SeerLikeJazz/USB3300_SpeedTest/README.md

# USB3300_SpeedTest
stm32407+Usb3300, HS USB2.0 speed test  

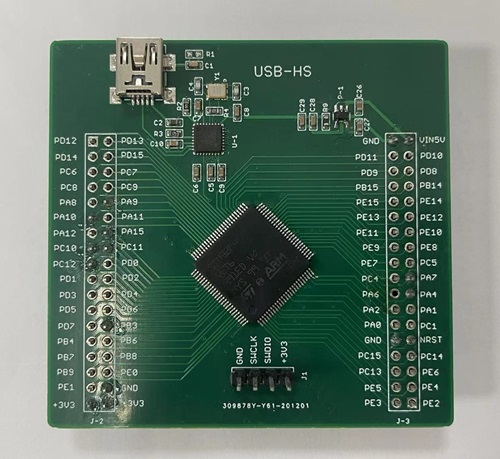
[picture p1: Image/PCB.jpg]
  
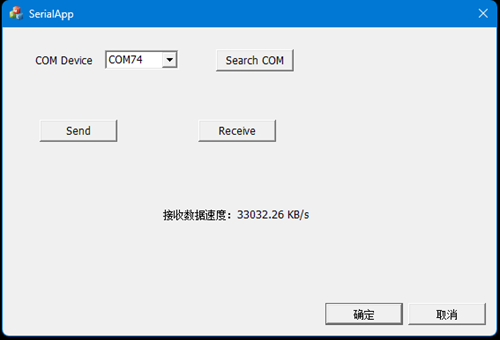
[picture p2: Image/ReceiveSpeed.png]
  
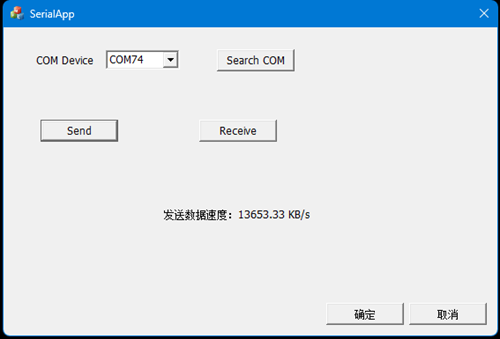
[picture p3: Image/SendSpeed.png]
  

## Todo
- 用python测试USB发送接收速度

### 23.11.28
- USB接口不给stm32芯片供电，需要从VIN5V供电
- 整理之前的资料
