SeerLikeJazz/USB3300_SpeedTest/上位机速度测试软件/SerialApp/SerialApp/ReadMe.txt

本程序是测试STM32F407虚拟串口通讯的上位机示例程序。

	碧云天书

====================================== 修改记录 ======================================

修补了从STM32读数据的漏洞。发出停止指令之后，要把STM32已经排队发送的数据也读出来，以免阻塞主循环。
	2014年10月4日
