SeerLikeJazz/USB3300_SpeedTest/Hardware/USB3300.pdf

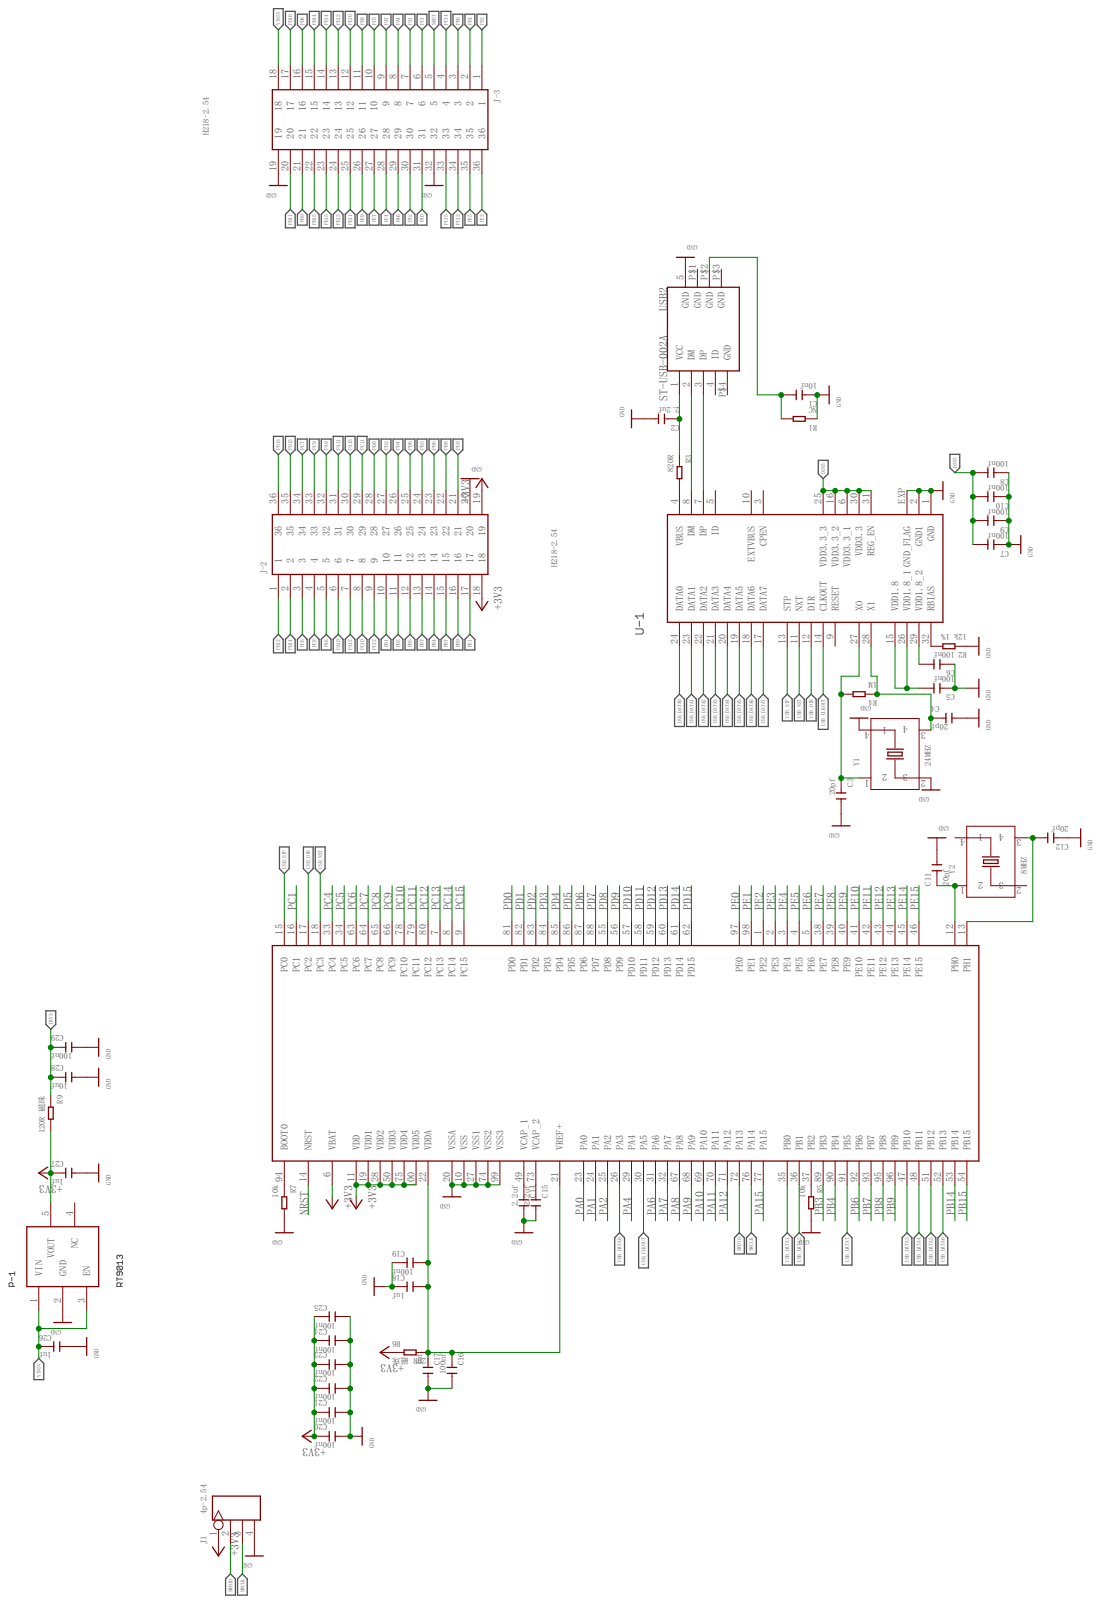
[picture p4: page 1]
