SeerLikeJazz/USB3300_SpeedTest/Hardware/USB3300.brd

## EAGLE design Hardware/USB3300.brd (2023-11-28)

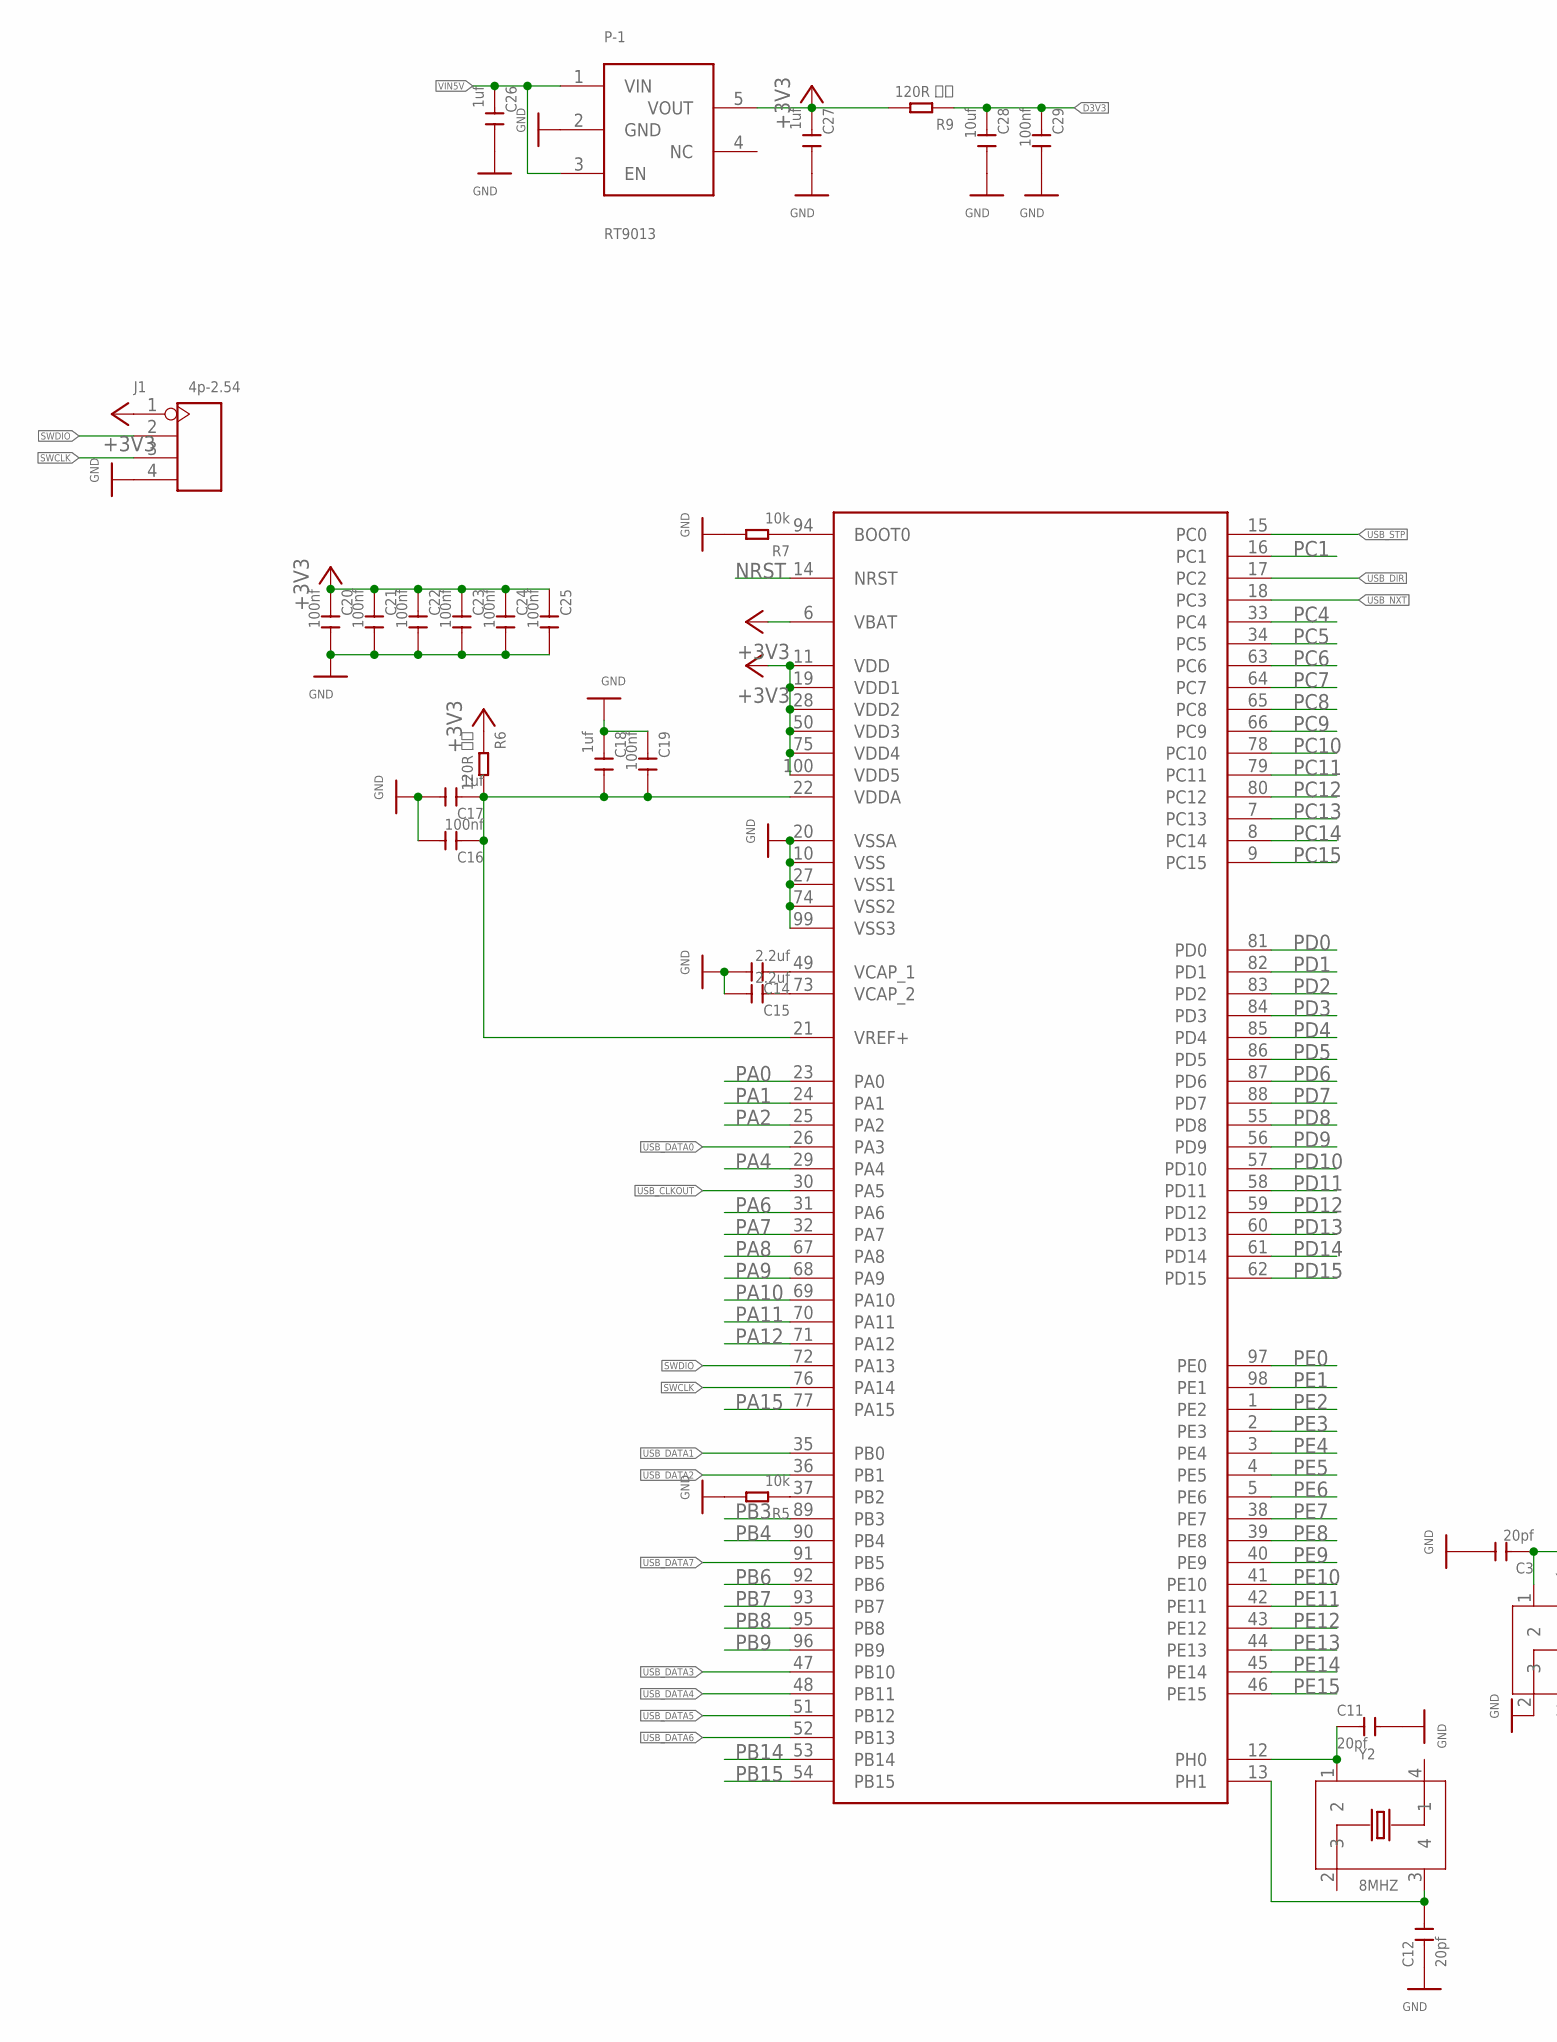
[picture p5: schematic USB3300.sch, part in row 1, column 1]

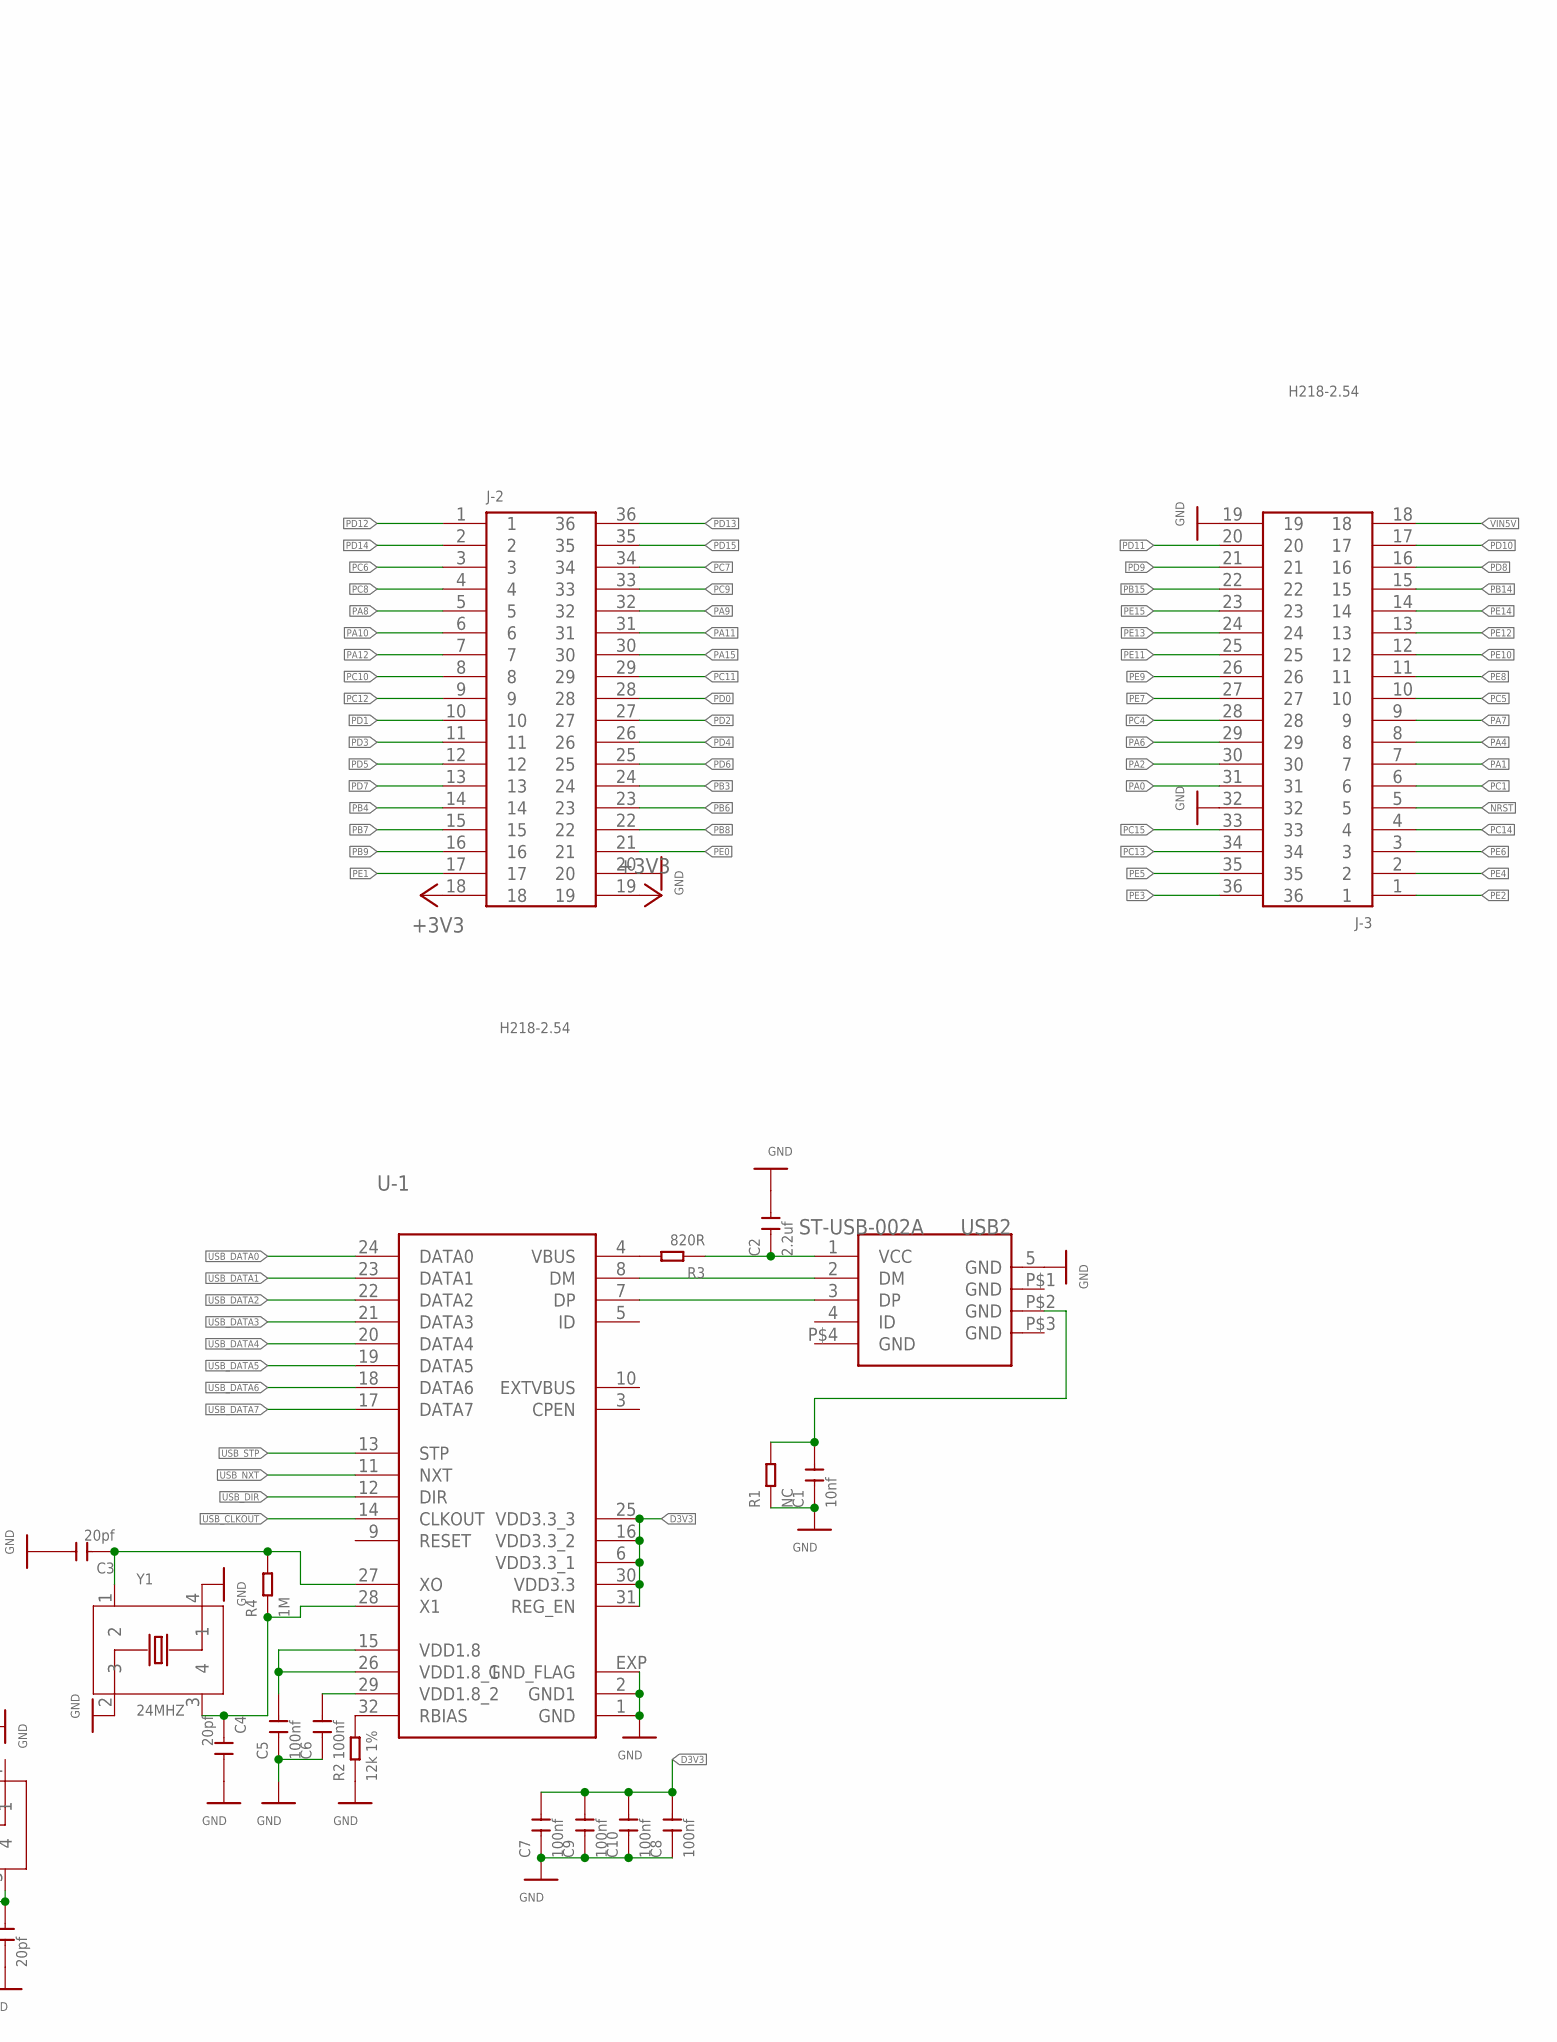
[picture p6: schematic USB3300.sch, part in row 1, column 2]

Parts:
C1: 10nf; C0603
C2, C14, C15: 2.2uf; C0603
C3, C4, C11, C12: 20pf; C0603
C5, C6, C7, C8, C9, C10, C16, C19, C20, C21, C22, C23, C24, C25, C29: 100nf; C0603
C17, C18, C26, C27: 1uf; C0603
C28: 10uf; C0603
J1: 4p-2.54; H4-2.54
J-2, J-3: H218-2.54; H2X18-2.54
P-1: RT9013; SOT23-5
R1: NC; R0603
R2: 12k 1%; R0603
R3: 820R; R0603
R4: 1M; R0603
R5, R7: 10k; R0603
R6, R9: 120R 磁珠; R0603
U$1: STM32F40XSTM32D40X; LQFP100
U-1: USB3300; QFN32
USB2: ST-USB-002A; MINIUSB5+4P-SMD-0.8-90D
Y1: 24MHZ; X4-SMD-3.2X2.5X0.7MM
Y2: 8MHZ; X4-SMD-3.2X2.5X0.7MM

Connections:
+3V3: C20.1, C21.1, C22.1, C23.1, C24.1, C25.1, C27.1, J1.1, J-2.18, J-2.19, P-1.5 (VOUT), R6.1, R9.2, U$1.6 (VBAT), U$1.11 (VDD), U$1.19 (VDD1), U$1.28 (VDD2), U$1.50 (VDD3), U$1.75 (VDD4), U$1.100 (VDD5)
D3V3: C7.2, C8.2, C9.2, C10.2, C28.1, C29.1, R9.1, U-1.6 (VDD3.3_1), U-1.16 (VDD3.3_2), U-1.25 (VDD3.3_3), U-1.30 (VDD3.3), U-1.31 (REG_EN)
GND: C1.1, C2.2, C3.2, C4.2, C5.1, C6.1, C7.1, C8.1, C9.1, C10.1, C11.2, C12.1, C14.2, C15.2, C16.2, C17.2, C18.1, C19.1, C20.2, C21.2, C22.2, C23.2, C24.2, C25.2, C26.2, C27.2, C28.2, C29.2, J1.4, J-2.20, J-3.19, J-3.32, P-1.2 (GND), R1.1, R2.1, R5.2, R7.2, U$1.10 (VSS), U$1.20 (VSSA), U$1.27 (VSS1), U$1.74 (VSS2), U$1.99 (VSS3), U-1.1 (GND), U-1.2 (GND1), U-1.EXP (GND_FLAG), USB2.5 (GND), Y1.2 (3), Y1.4 (1)
unnamed: U-1.8 (DM), USB2.2 (DM)
unnamed: U-1.7 (DP), USB2.3 (DP)
unnamed: C3.1, R4.2, U-1.27 (XO), Y1.1 (2)
unnamed: R2.2, U-1.32 (RBIAS)
unnamed: R3.2, U-1.4 (VBUS)
unnamed: C4.1, R4.1, U-1.28 (X1), Y1.3 (4)
unnamed: C5.2, U-1.15 (VDD1.8), U-1.26 (VDD1.8_1)
unnamed: C6.2, U-1.29 (VDD1.8_2)
unnamed: C11.1, U$1.12 (PH0), Y2.1 (2)
unnamed: C12.2, U$1.13 (PH1), Y2.3 (4)
unnamed: R7.1, U$1.94 (BOOT0)
unnamed: C16.1, C17.1, C18.2, C19.2, R6.2, U$1.21 (VREF+), U$1.22 (VDDA)
unnamed: C14.1, U$1.49 (VCAP_1)
unnamed: C15.1, U$1.73 (VCAP_2)
unnamed: C2.1, R3.1, USB2.1 (VCC)
unnamed: R5.1, U$1.37 (PB2)
unnamed: C1.2, R1.2, USB2.P$2 (GND)
NRST: J-3.5, U$1.14 (NRST)
PA0: J-3.31, U$1.23 (PA0)
PA1: J-3.7, U$1.24 (PA1)
PA2: J-3.30, U$1.25 (PA2)
PA4: J-3.8, U$1.29 (PA4)
PA6: J-3.29, U$1.31 (PA6)
PA7: J-3.9, U$1.32 (PA7)
PA8: J-2.5, U$1.67 (PA8)
PA9: J-2.32, U$1.68 (PA9)
PA10: J-2.6, U$1.69 (PA10)
PA11: J-2.31, U$1.70 (PA11)
PA12: J-2.7, U$1.71 (PA12)
PA15: J-2.30, U$1.77 (PA15)
PB3: J-2.24, U$1.89 (PB3)
PB4: J-2.14, U$1.90 (PB4)
PB6: J-2.23, U$1.92 (PB6)
PB7: J-2.15, U$1.93 (PB7)
PB8: J-2.22, U$1.95 (PB8)
PB9: J-2.16, U$1.96 (PB9)
PB14: J-3.15, U$1.53 (PB14)
PB15: J-3.22, U$1.54 (PB15)
PC1: J-3.6, U$1.16 (PC1)
PC4: J-3.28, U$1.33 (PC4)
PC5: J-3.10, U$1.34 (PC5)
PC6: J-2.3, U$1.63 (PC6)
PC7: J-2.34, U$1.64 (PC7)
PC8: J-2.4, U$1.65 (PC8)
PC9: J-2.33, U$1.66 (PC9)
PC10: J-2.8, U$1.78 (PC10)
PC11: J-2.29, U$1.79 (PC11)
PC12: J-2.9, U$1.80 (PC12)
PC13: J-3.34, U$1.7 (PC13)
PC14: J-3.4, U$1.8 (PC14)
PC15: J-3.33, U$1.9 (PC15)
PD0: J-2.28, U$1.81 (PD0)
PD1: J-2.10, U$1.82 (PD1)
PD2: J-2.27, U$1.83 (PD2)
PD3: J-2.11, U$1.84 (PD3)
PD4: J-2.26, U$1.85 (PD4)
PD5: J-2.12, U$1.86 (PD5)
PD6: J-2.25, U$1.87 (PD6)
PD7: J-2.13, U$1.88 (PD7)
PD8: J-3.16, U$1.55 (PD8)
PD9: J-3.21, U$1.56 (PD9)
PD10: J-3.17, U$1.57 (PD10)
PD11: J-3.20, U$1.58 (PD11)
PD12: J-2.1, U$1.59 (PD12)
PD13: J-2.36, U$1.60 (PD13)
PD14: J-2.2, U$1.61 (PD14)
PD15: J-2.35, U$1.62 (PD15)
PE0: J-2.21, U$1.97 (PE0)
PE1: J-2.17, U$1.98 (PE1)
PE2: J-3.1, U$1.1 (PE2)
PE3: J-3.36, U$1.2 (PE3)
PE4: J-3.2, U$1.3 (PE4)
PE5: J-3.35, U$1.4 (PE5)
PE6: J-3.3, U$1.5 (PE6)
PE7: J-3.27, U$1.38 (PE7)
PE8: J-3.11, U$1.39 (PE8)
PE9: J-3.26, U$1.40 (PE9)
PE10: J-3.12, U$1.41 (PE10)
PE11: J-3.25, U$1.42 (PE11)
PE12: J-3.13, U$1.43 (PE12)
PE13: J-3.24, U$1.44 (PE13)
PE14: J-3.14, U$1.45 (PE14)
PE15: J-3.23, U$1.46 (PE15)
SWCLK: J1.3, U$1.76 (PA14)
SWDIO: J1.2, U$1.72 (PA13)
USB_CLKOUT: U$1.30 (PA5), U-1.14 (CLKOUT)
USB_DATA0: U$1.26 (PA3), U-1.24 (DATA0)
USB_DATA1: U$1.35 (PB0), U-1.23 (DATA1)
USB_DATA2: U$1.36 (PB1), U-1.22 (DATA2)
USB_DATA3: U$1.47 (PB10), U-1.21 (DATA3)
USB_DATA4: U$1.48 (PB11), U-1.20 (DATA4)
USB_DATA5: U$1.51 (PB12), U-1.19 (DATA5)
USB_DATA6: U$1.52 (PB13), U-1.18 (DATA6)
USB_DATA7: U$1.91 (PB5), U-1.17 (DATA7)
USB_DIR: U$1.17 (PC2), U-1.12 (DIR)
USB_NXT: U$1.18 (PC3), U-1.11 (NXT)
USB_STP: U$1.15 (PC0), U-1.13 (STP)
VIN5V: C26.1, J-3.18, P-1.1 (VIN), P-1.3 (EN)

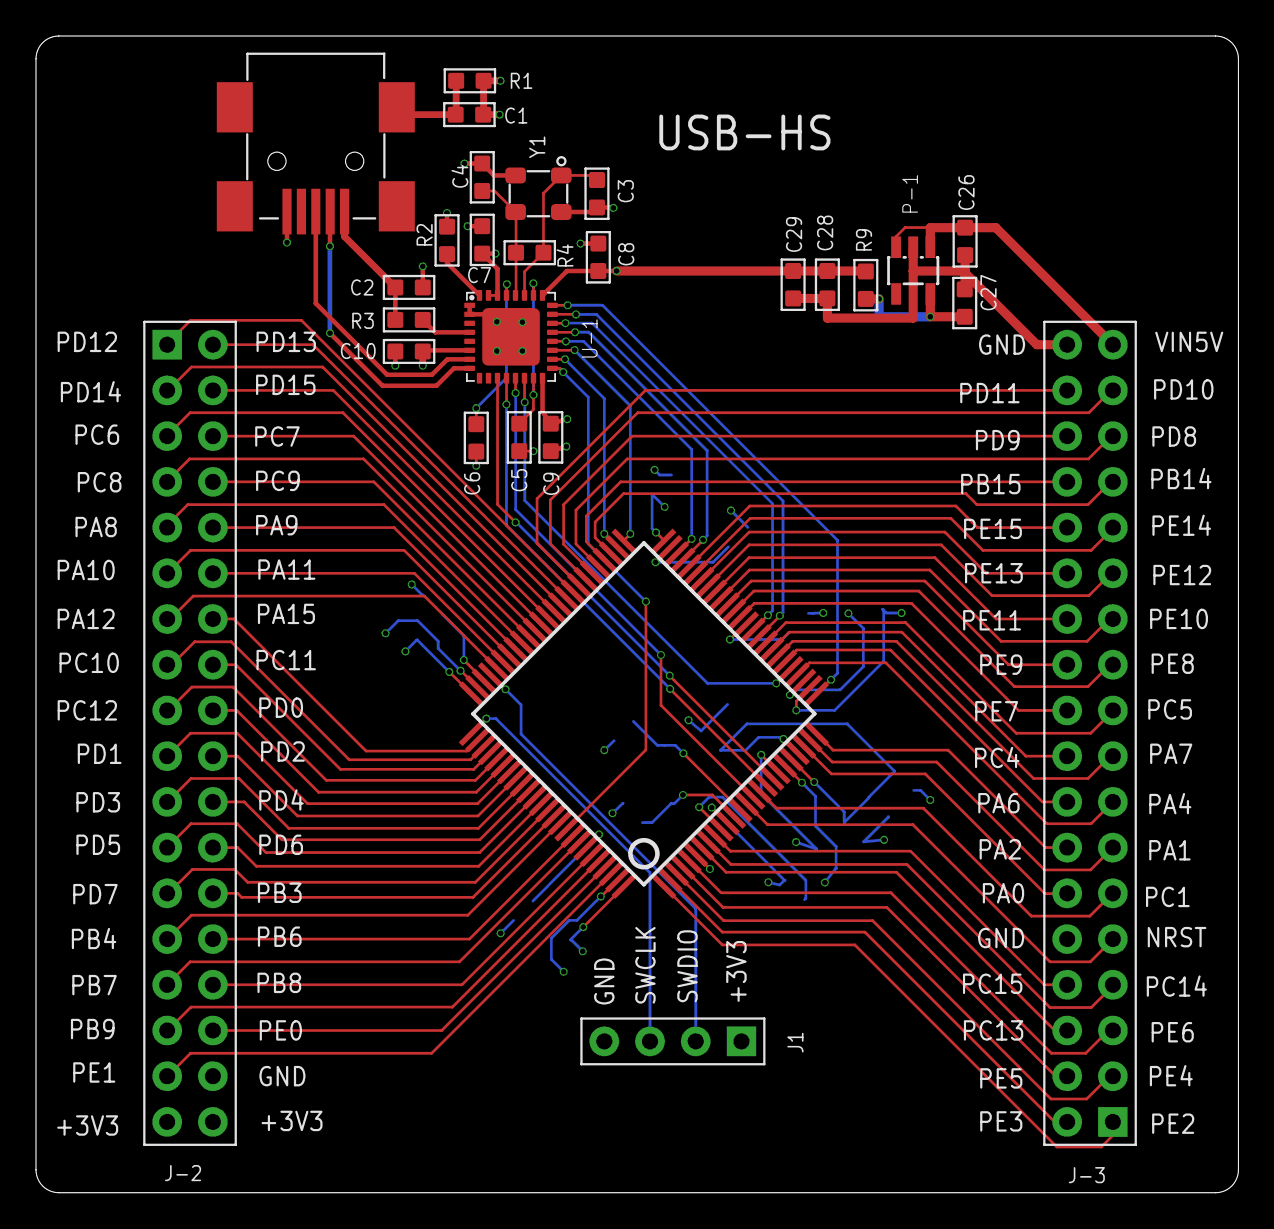
[picture p7: board USB3300.brd from above]

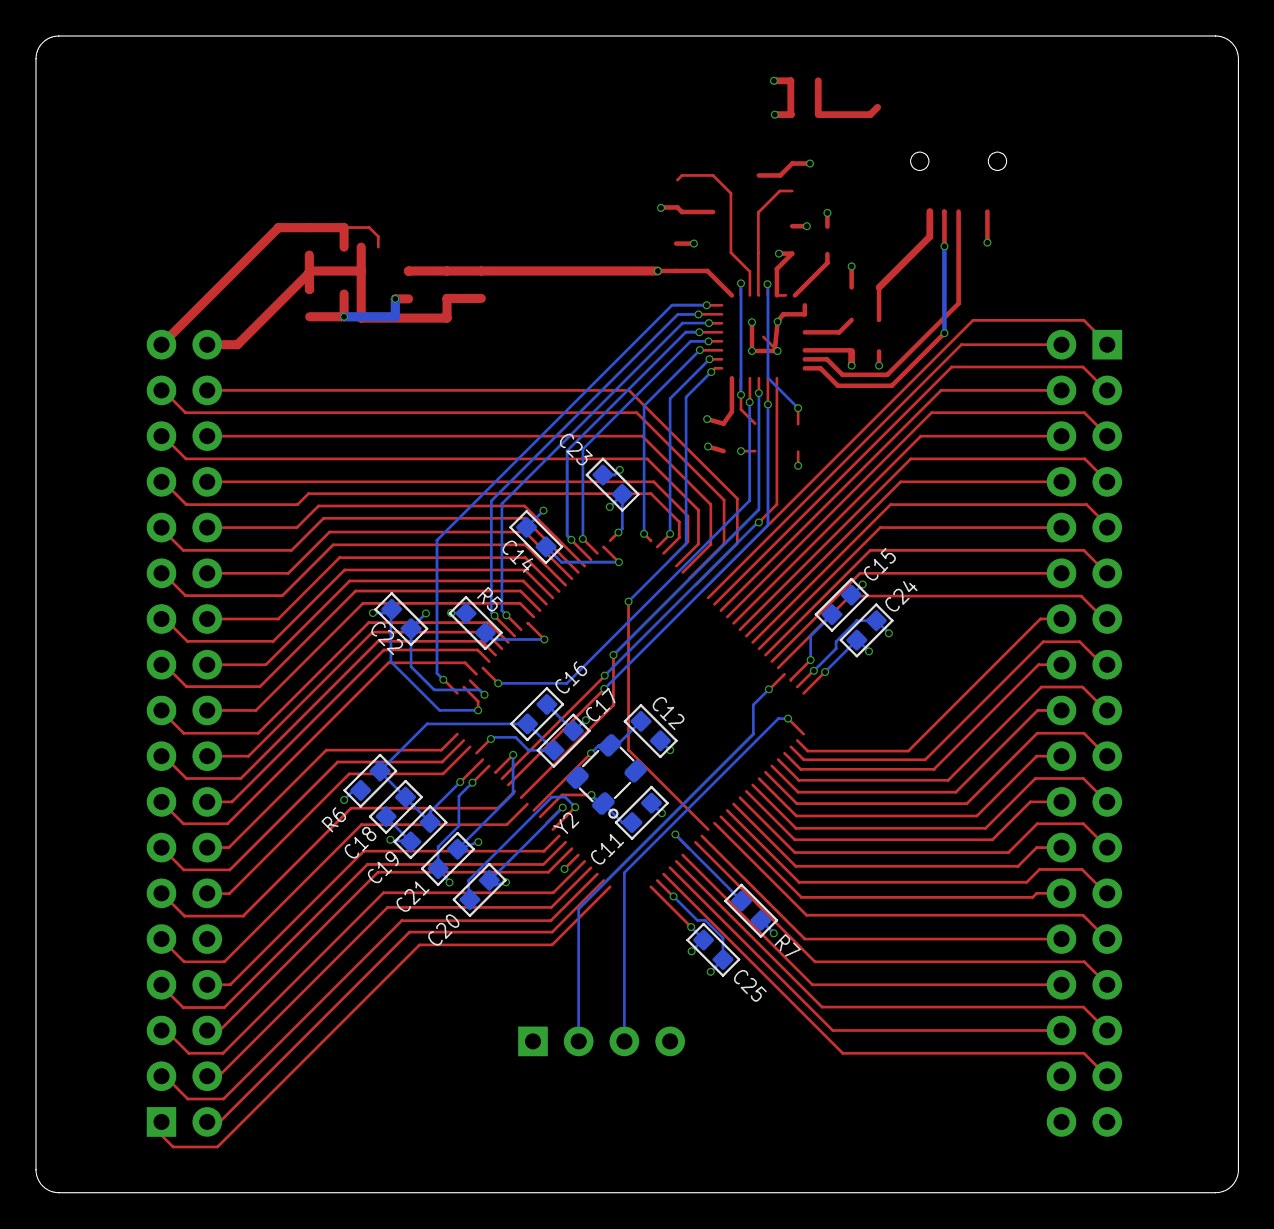
[picture p8: board USB3300.brd from below]

Board: 4 copper layers, 66.8 x 64.3 mm, 45 parts (18 on the bottom side), 101 nets.
