SeerLikeJazz/USB3300_SpeedTest/USB_HS_test/test/test.ioc

Mcu.UserName=STM32F407IGTx
PA13.Signal=SYS_JTMS-SWDIO
PA14.Signal=SYS_JTCK-SWCLK
PA3.Signal=USB_OTG_HS_ULPI_D0
PA5.Signal=USB_OTG_HS_ULPI_CK
PB0.Signal=USB_OTG_HS_ULPI_D1
PB1.Signal=USB_OTG_HS_ULPI_D2
PB10.Signal=USB_OTG_HS_ULPI_D3
PB11.Signal=USB_OTG_HS_ULPI_D4
PB12.Signal=USB_OTG_HS_ULPI_D5
PB13.Signal=USB_OTG_HS_ULPI_D6
PB5.Signal=USB_OTG_HS_ULPI_D7
PC0.Signal=USB_OTG_HS_ULPI_STP
PH0-OSC_IN.Signal=RCC_OSC_IN
PH1-OSC_OUT.Signal=RCC_OSC_OUT
PH4.Signal=USB_OTG_HS_ULPI_NXT
PI11.Signal=USB_OTG_HS_ULPI_DIR
