SeerLikeJazz/USB3300_SpeedTest/USB_HS_test/test/Core/Src/main.c

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
/* Includes ------------------------------------------------------------------*/
#include "main.h"
#include "usb_device.h"
#include "gpio.h"

/* USER CODE BEGIN Includes */
#include "usbd_cdc_if.h"
/* USER CODE END Includes */


/* USER CODE BEGIN PV */
#define TxBufSize 20480
int bSendMark = 0;				//// 发送数据的标志
uint8_t SendData[TxBufSize];


extern uint8_t UserRxBuffer[2][APP_RX_DATA_SIZE];//// 用双缓存保存数据
extern uint32_t nRxLength;		//// 接收到的数据长度
extern uint8_t uRxBufIndex;		//// 当前使用的缓冲区索引号
extern uint8_t  uLastRxBufIndex;//// 上次使用的接收缓冲区索引号
/* USER CODE END PV */

void SystemClock_Config(void);
/**
  * @brief  The application entry point.
  * @retval int
  */
int main(void)
{
  /* MCU Configuration--------------------------------------------------------*/

  /* Reset of all peripherals, Initializes the Flash interface and the Systick. */
  HAL_Init();

  /* Configure the system clock */
  SystemClock_Config();

  /* Initialize all configured peripherals */
  MX_GPIO_Init();
  MX_USB_DEVICE_Init();
  /* Infinite loop */
  /* USER CODE BEGIN WHILE */
  while (1)
  {
    /* USER CODE END WHILE */

    /* USER CODE BEGIN 3 */
		// 处理接收到的数据：解码数据流中的指令。可以改成你自己的数据处理过程。
		// 每次CDC_Itf_Receive()接收到新数据都会更换缓存，所以发现缓存切换过就是有新的数据。
		// 这里必须保证数据处理的速度足够快，否则缓存切换了两次才处理的话，就没法识别有新数据到来了。
		if (uLastRxBufIndex != uRxBufIndex)
		{
			// --> 指令译码开始。
			for (int i=0; i<nRxLength; i++)
			{
				if (UserRxBuffer[uLastRxBufIndex][i] == 0x55)	// 0x55, 开始发送数据指令
					bSendMark = 1;
				if (UserRxBuffer[uLastRxBufIndex][i] == 0xAA)	// 0xAA, 停止发送数据指令
					bSendMark = 0;
			}
			// <-- 指令译码结束。
			uLastRxBufIndex = (uLastRxBufIndex + 1) & 1;
		}

		if (bSendMark)
		{
			int32_t k = 0;
			while (CDC_Transmit_HS(SendData, TxBufSize) != USBD_OK)
				k++;
		}
  }
  /* USER CODE END 3 */
}

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
