SeerLikeJazz/USB3300_SpeedTest/(notices)

Notices in the files:
USB_HS_test/test/Core/Src/main.c:
© Copyright (c) 2020 STMicroelectronics.
All rights reserved.
This software component is licensed by ST under Ultimate Liberty license
